javinli123/Point-to-Point-Communication/cad/lid.png

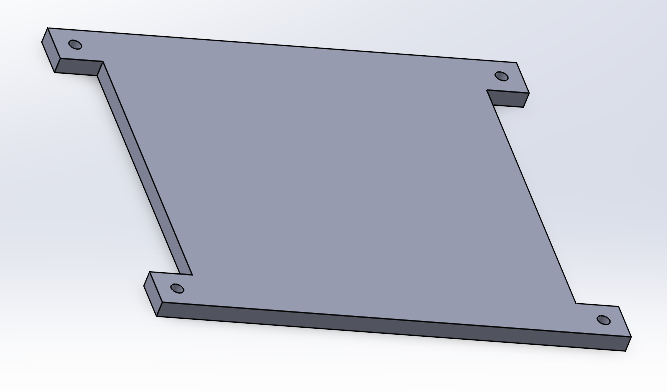
cad/lid.png
