javinli123/Point-to-Point-Communication/cad/mount.png

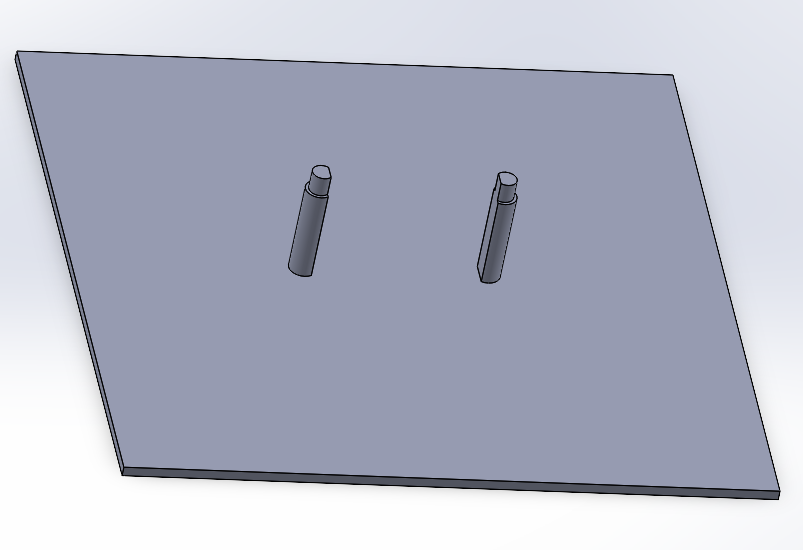
cad/mount.png
