javinli123/Point-to-Point-Communication/cad/receiver.png

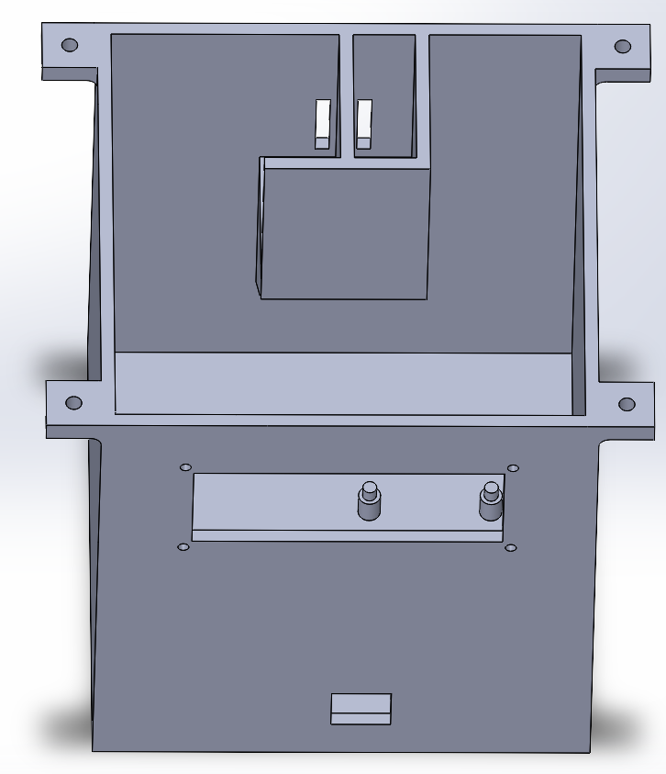
cad/receiver.png
