javinli123/Point-to-Point-Communication/cad/transmitter.png

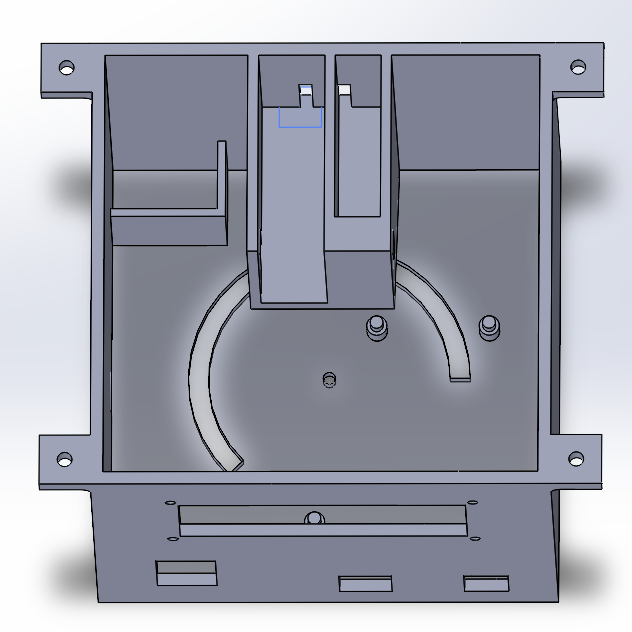
cad/transmitter.png
